TeamScheire/TijlPlay/MP3_play.md

We proberen een mp3 speler aan te sturen op basis van input van de microbit
Bedarding zoals in [1], eerste test met muziek met files zoalsin [2] 

## References

1.  [DFPlayer Mini MP3 Player For Arduino](https://wiki.dfrobot.com/DFPlayer_Mini_SKU_DFR0299)
2.  [Musical Box arduino+ BBCmicrobit](https://github.com/alicemirror/musicalbox)
3.  [Cheat Sheet](https://reprage.com/post/dfplayer-mini-cheat-sheet)
4.  [pin layout](https://community.particle.io/t/dfplayer-mini-pins/39414)
