TeamScheire/TijlPlay/testsketches/test03_data_overview.ods

Sheet: Overview
Observaties:
 | 1. meeting bluetooth maar elke 100 tot 150 ms
 | ==> niet vlug genoeg om uit te middelen! Stap is maar rond 500 …
 | 2. Duidelijk verschil
 | Cri Normaal | Cri Toewalk
 | Leila Normaal | Leila Toewalk
 | Benny Normaal | Benny Toewalk

Sheet: test03_data_ben01_normaal
1564065093.70858 | 0 | 1091.17184714416 | -144 | -1072 | -144 | 3.03789315241168 | 2.99189304997299
1564065093.80845 | 0.099869966506958 | 906.933294129177 | -384 | -816 | -96 | 2.95757534543168 | 2.98135767223822 | -0.804223830138193
1564065093.90897 | 0.200390100479126 | 955.455912117352 | -304 | -864 | -272 | 2.98021065207559 | 2.99532761894508 | 0.225181819297777
1564065094.00849 | 0.299910068511963 | 1014.58168719921 | -144 | -928 | -384 | 3.00628701920738 | 3.00108069607587 | 0.262021458077464
1564065094.10847 | 0.399889945983887 | 998.815298240871 | -304 | -896 | -320 | 2.99948518555227 | 2.98513574440087 | -0.068032026314693
1564065094.25855 | 0.549969911575317 | 994.191128505983 | -224 | -896 | -368 | 2.99746988346795 | 2.97314352158989 | -0.013428188608509
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
