TeamScheire/TijlPlay/testsketches/test03a_sendaccel2bluetooth.png

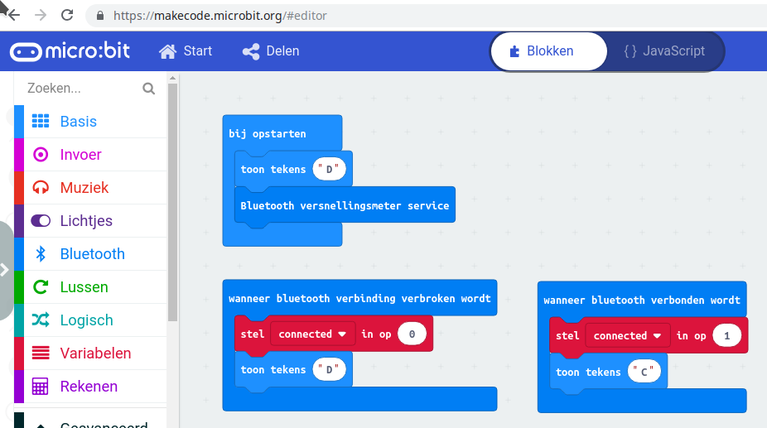
testsketches/test03a_sendaccel2bluetooth.png
