TeamScheire/TijlPlay/testsketches/test04_avgspeed_vs_avgshock.png

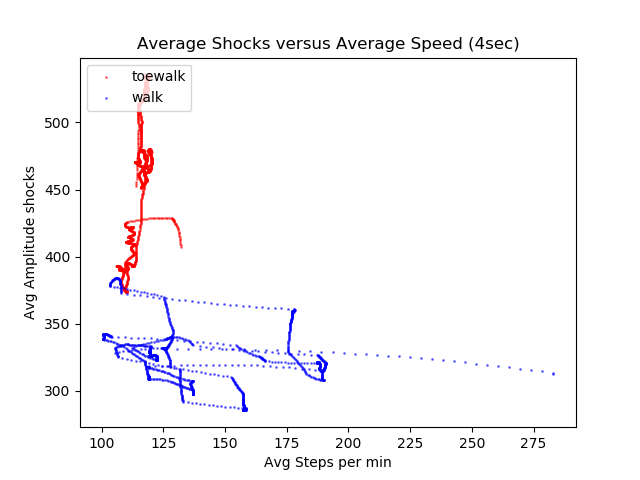
testsketches/test04_avgspeed_vs_avgshock.png
